txomin-guardia/ROUSGARDEN/image/ROUSGarden 2.jpg

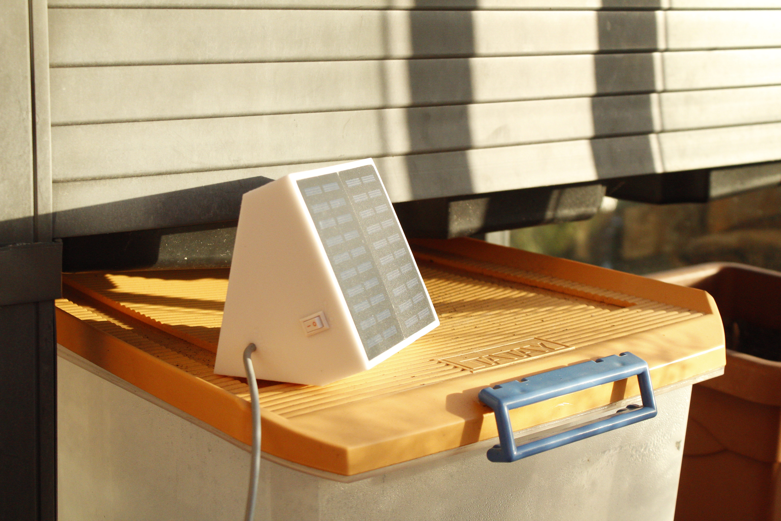
image/ROUSGarden 2.jpg
