txomin-guardia/ROUSGARDEN/image/ROUSGarden 4.jpg

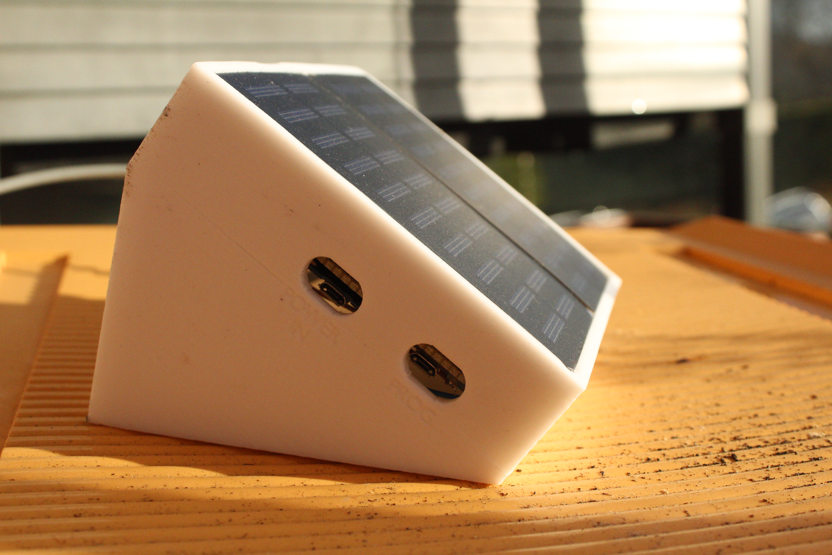
image/ROUSGarden 4.jpg
