txomin-guardia/ROUSGARDEN/image/ROUSGarden 5.jpg

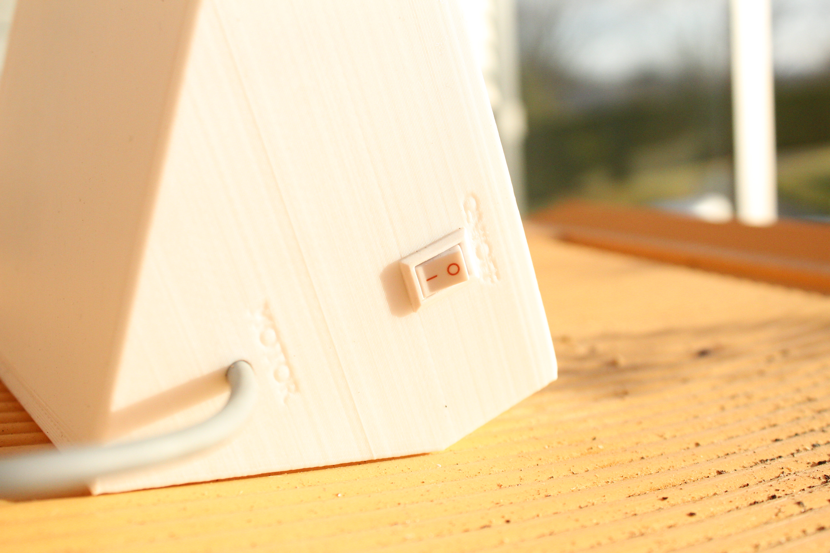
image/ROUSGarden 5.jpg
