txomin-guardia/ROUSGARDEN/image/ROUSGarden 6.jpg

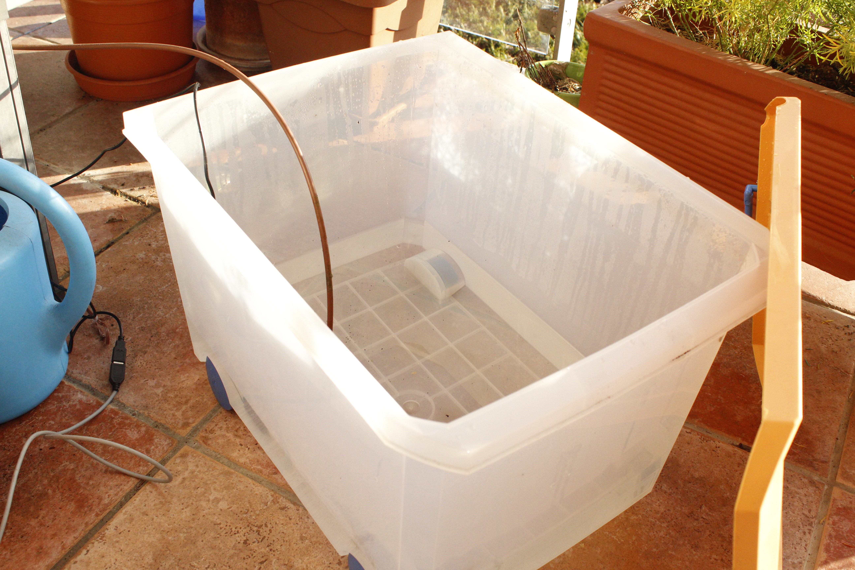
image/ROUSGarden 6.jpg
