txomin-guardia/ROUSGARDEN/image/ROUSGarden 7.jpg

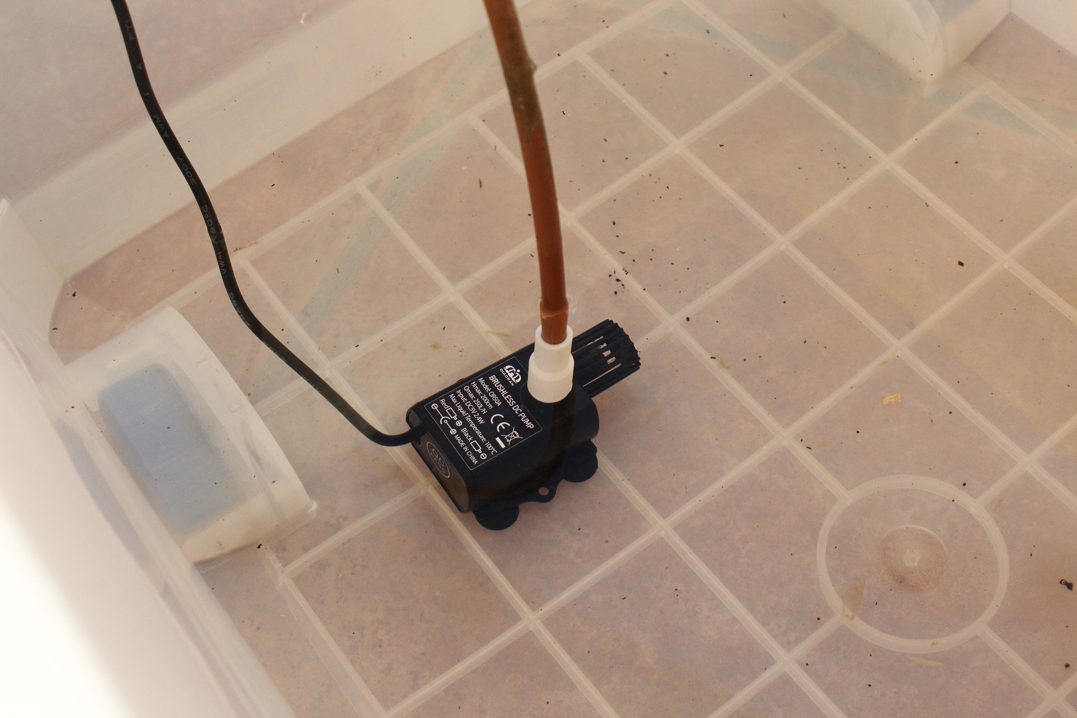
image/ROUSGarden 7.jpg
