txomin-guardia/ROUSGARDEN/image/ROUSGardeN - Case 1.png

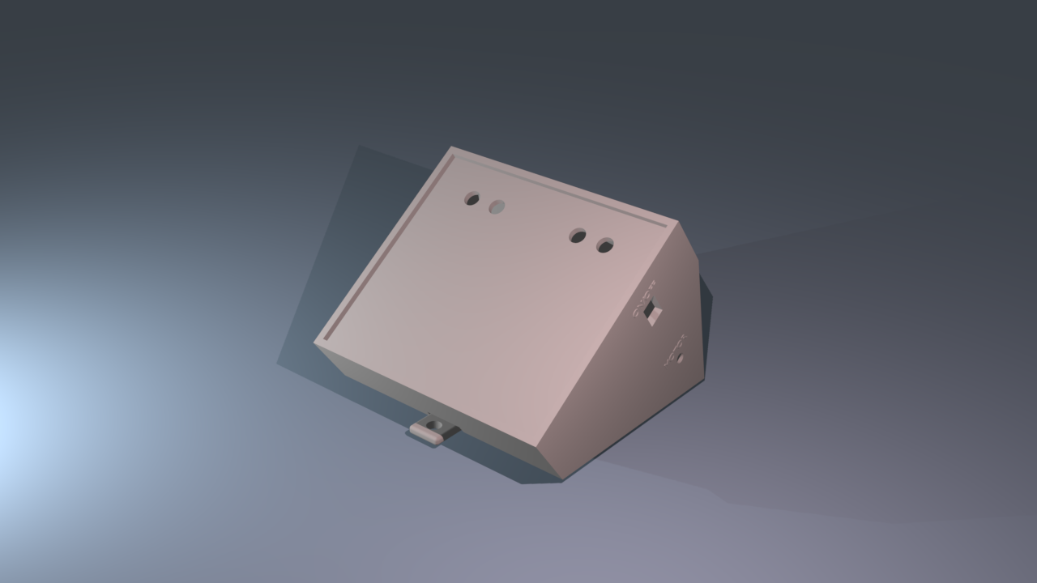
image/ROUSGardeN - Case 1.png
