txomin-guardia/ROUSGARDEN/doc/ROUSGardeN 1.0 - BOM.md

ROUSGardeN 1.0
==============

BILL OF MATERIALS

* 1 x Mini wifi board WEMOS D1 Mini V3.0.0 WIFI ESP8266 4MB (https://www.banggood.com/Geekcreit-D1-Mini-V3_0_0-WIFI-Internet-Of-Things-Development-Board-Based-ESP8266-4MB-p-1264245.html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)
* 1 x DC 5V 1CH Relay Shield V2 Version 2 For D1 Mini ESP8266 WiFi Module (https://www.banggood.com/DC-5V-1CH-Relay-Shield-V2-Version-2-For-D1-Mini-ESP8266-WiFi-Module-p-1102379.html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)
* 1 x 3.7V 9V 5V 2A Adjustable Step Up 3,7V Lithium Battery Charging Discharge Integrated Module (https://www.banggood.com/3_7V-9V-5V-2A-Adjustable-Step-Up-18650-Lithium-Battery-Charging-Discharge-Integrated-Module-p-1264852.html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)
* 1 x Rechargeable Batery 3.7V 4000mAh Li-polymer Battery 5050100 Li-Po (https://es.aliexpress.com/item/32810827153.html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)
* 2 x 107mm x 61mm 1 Watt 5 Volts Monocrystalline Solar Cell Panel Module (https://es.aliexpress.com/item/33043118065.html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,scm-url:1007.40050.281175.0,pvid:6043324d-6fd0-4a92-81bd-c17b8e9e5d3b,tpp_buckets:668%232846%238110%231995&pdp_ext_f=%7B%22sku_id%22%3A%2267356190824%22%2C%22sceneId%22%3A%2230050%22%7D&pdp_npi=2%40dis%21EUR%211.81%211.67%21%21%21%21%21%400b0a23ae16677584363356863e7c06%2167356190824%21rec)
* 1 x Brushless mini waterpump USB DC 5V 2.4W 250L / 2m (https://www.amazon.es/dp/B07KQ1W4NP/ref=cm_sw_r_em_apap_VDhx8IsJr9Qqy)
* 1 x KCD11 Rocker Switch 10*15mm Mini Push Button Switch ON-OFF 3 Pins 3A 250VAC(https://www.aliexpress.com/item/4000973563250.html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)
