txomin-guardia/ROUSGARDEN/doc/ROUSGardeN 1.0 - Circuit Diagram.pdf

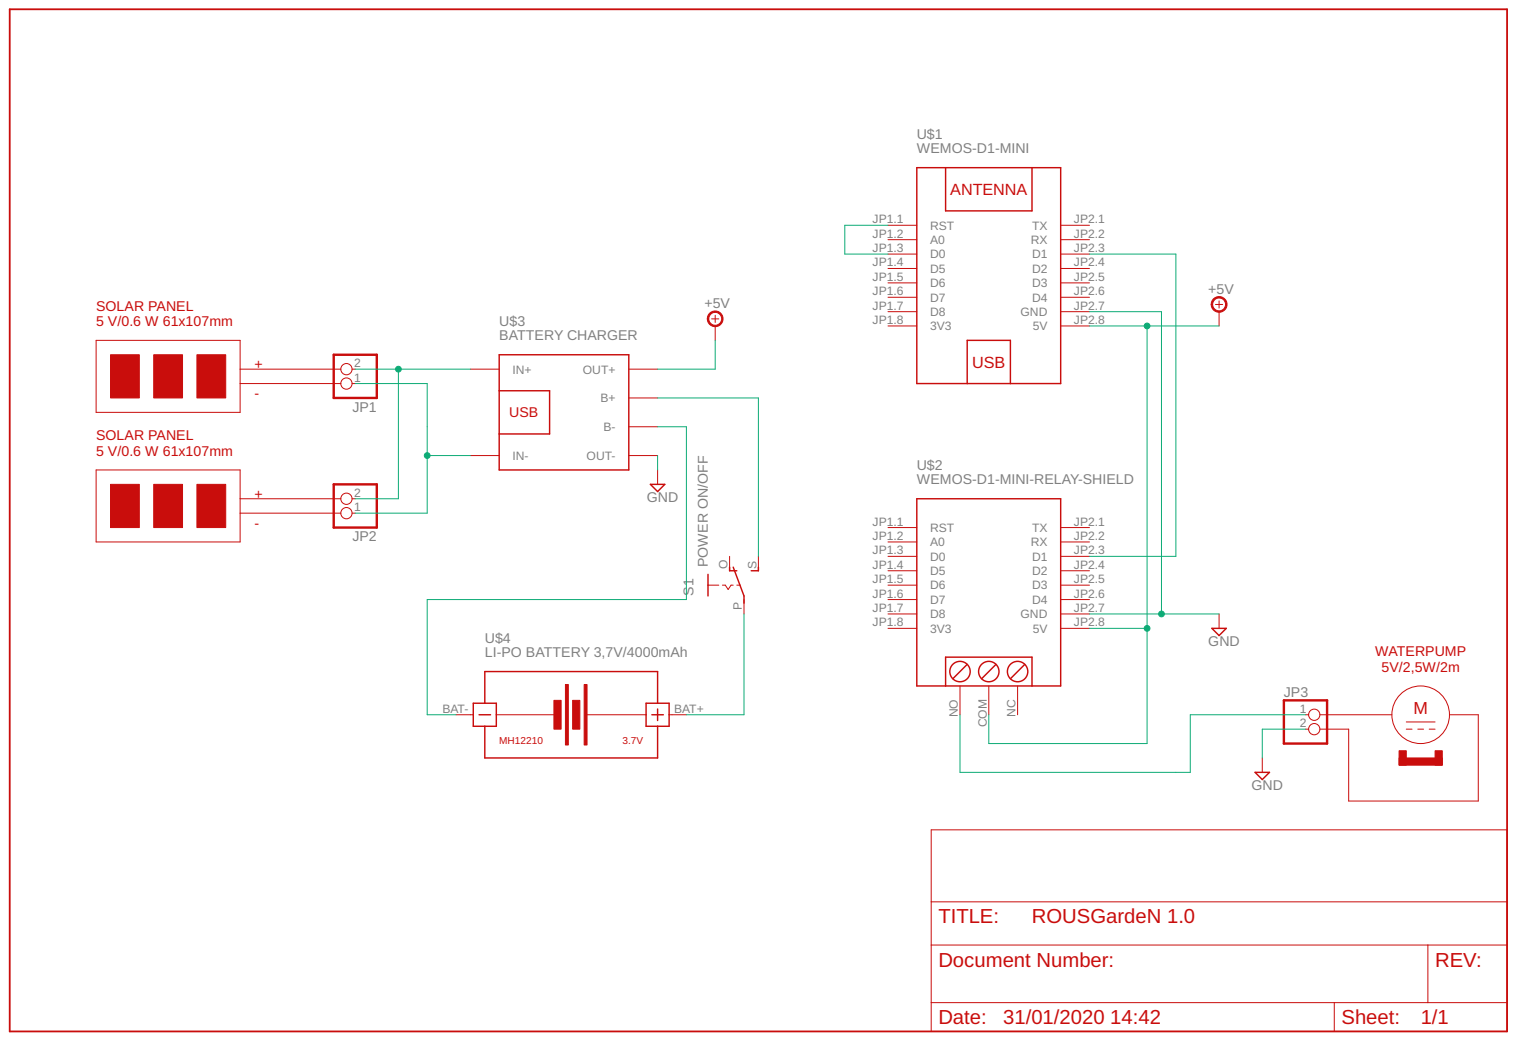
[picture p12: page 1]

WER ON/OFF GND

WEMOS-D1-MINI-RELAY-SHIELD

JP2.3 D2 JP2.4 D3 JP2.5 D4 JP2.6 GND JP2.7

Document Number: | REV:

Date: 31/01/2020 14:42 | Sheet: 1/1
