txomin-guardia/ROUSGARDEN/ROUSGardeN/RousGarden.ino

/* ROUSGardeN
    
    Autonomous and Unattended Watering System, ESP8266 controlled with two daily tasks
    
    Copyright (c) 2019 Txomin Guardia
    
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
    V1.0 2019-10-6
        
    (^\s*if \(WithSerialDebug\) \{)(.*?)(\})
    
    \n#if WITH_SERIAL_DEBUG\2\#endif
*/

#include <ESP8266WiFi.h>
#include <CayenneMQTTESP8266.h>
#include "credentials.h"
#include "ESPRelayTaskNTP.h"

extern "C" {
    #include "user_interface.h" // this is for the RTC memory read/write functions
}

// WEMOS_D1_MINI used pins to control relay
#define RESET_PIN 12  //It corresponds to WEMOS D1 MINI - pin D6
#define RELAY_ON_PIN 5  //It corresponds to WEMOS D1 MINI - pin D1

#define WITH_SERIAL_DEBUG 1
//#define WITH_CAYENNE_DEBUG 1

//Working with Cayenne
#if WITH_CAYENNE_DEBUG
    #define CAYENNE_PRINT Serial
#endif

//On & Off enumeration
enum OnOffOption {
    Off,
    On
};

// Debugging through Cayenne IoT Project Builder
const OnOffOption WithCayenneDebug = Off;

// This is the instatiation of the main class that controls the relay
// Usage:   relayTask(Task #1 Hour, Task #1 Minute, Task #1 Time On (seg), Task #2 Hour, Task #2 Minute, Task #2 Time On (seg), Timezone, WiFi SSID, WiFi PASSWORD, Reset Pin);
// Only Task 1 will be executed if the hour and minute of Task 2 is less than that of Task 1.
ESPRelayTaskNTP relayTask(0, 0, 0, 0, 0, 0, 1.0, my_SSID, my_PASSWORD, RESET_PIN);

void setup() {
    unsigned int timeTaskOn;
    
    #if WITH_SERIAL_DEBUG
        Serial.begin(115200);
        while (!Serial) {
            ; // wait for serial port to connect. Needed for native USB
        }
        Serial.println();   Serial.println("Start");   Serial.println();
    #endif
    
    //Relay task schedule configuration
    relayTask._wakeupTask1.hour = 8; //Hour of the day
    relayTask._wakeupTask1.minute = 0; //Minute of the day
    relayTask._wakeupTask1.second = 60; //Duration in sec
    relayTask._wakeupTask2.hour = 20; //Hour of the day
    relayTask._wakeupTask2.minute = 5; //Minute of the day
    relayTask._wakeupTask2.second = 60; //Duration in sec
    
    relayTask.sleepOneDay();
    
    // ------------------ put the code for the tasks here -------------------------------
    
    if (WithCayenneDebug) {
        // Initialize Cayenne connection also activating the wifi because Wi-Fi is not
        // started by default when the job is activated.
        Cayenne.begin(username, password, clientID, my_SSID, my_PASSWORD);
        // Inform Cayenne the ON state
        Cayenne.digitalSensorWrite(0, true);
    }
    
    timeTaskOn = relayTask.readTimeTaskOn();
    
    #if WITH_SERIAL_DEBUG
        Serial.println("............ W O R K I N G ............");
        Serial.print("Task in progress for ");
        Serial.print(timeTaskOn);
        Serial.println("s");
    #endif
    
    //Relay switch ON
    pinMode(RELAY_ON_PIN, OUTPUT);
    digitalWrite(RELAY_ON_PIN, true);
    
    delay(timeTaskOn * 1e3);
    
    digitalWrite(RELAY_ON_PIN, false);
    
    if (WithCayenneDebug) {
        // Inform Cayenne the OFF state
        Cayenne.digitalSensorWrite(0, false);
        delay(1000);
    }
    
    relayTask.backToSleep();
}

void loop() {
    // loop never reached
}
