txomin-guardia/ROUSGARDEN/(commit log)

2020-01-31 BOM added
2020-01-31 Update ROUSGardeN 1.0 - BOM.md
2022-11-06 Cambiada tienda de paneles solares
2024-12-04 Update ROUSGardeN 1.0 - BOM.md
    Añadida nueva referencia de batería
2024-12-04 Update ROUSGardeN 1.0 - BOM.md
    Añadido interruptor
