txomin-guardia/ROUSGARDEN/image/ROUSGarden 3.jpg

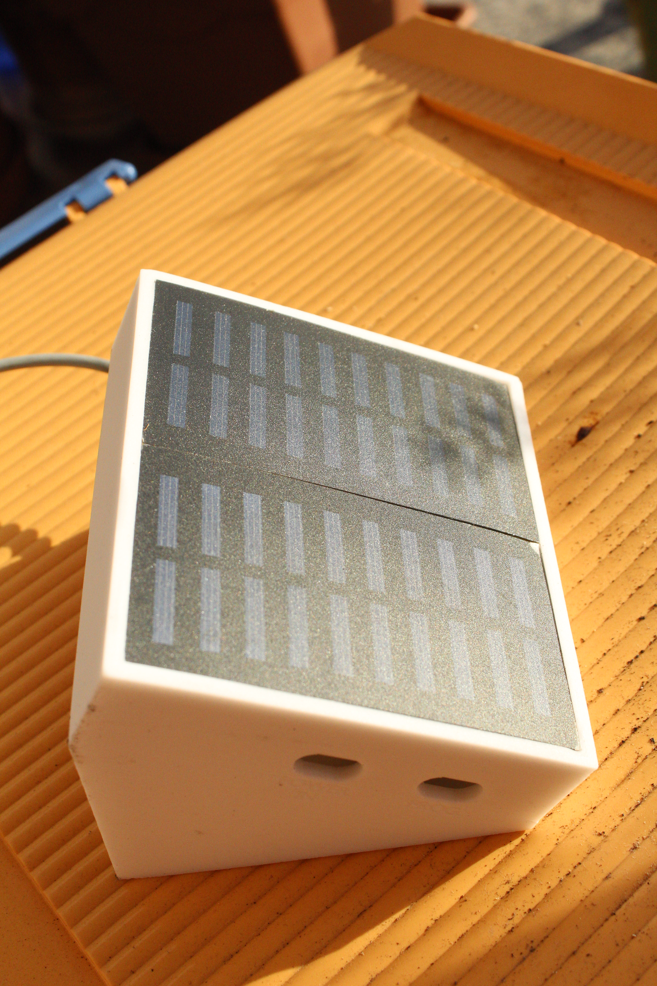
image/ROUSGarden 3.jpg
