txomin-guardia/ROUSGARDEN/image/ROUSGarden 9.jpg

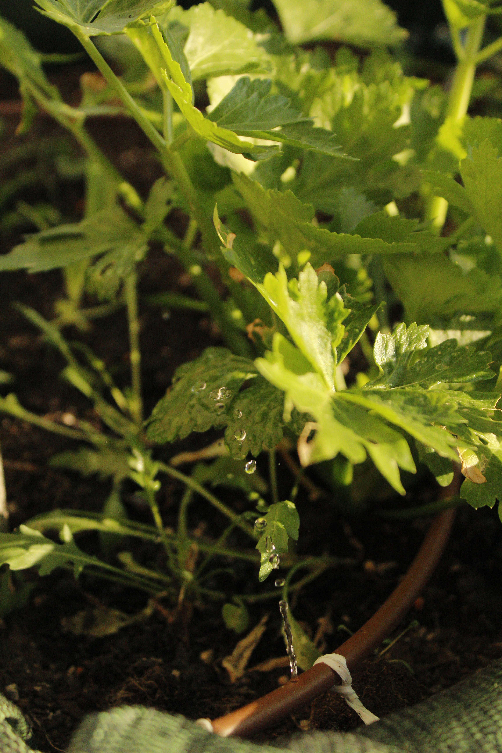
image/ROUSGarden 9.jpg
