txomin-guardia/ROUSGARDEN/image/ROUSGarden 10.jpg

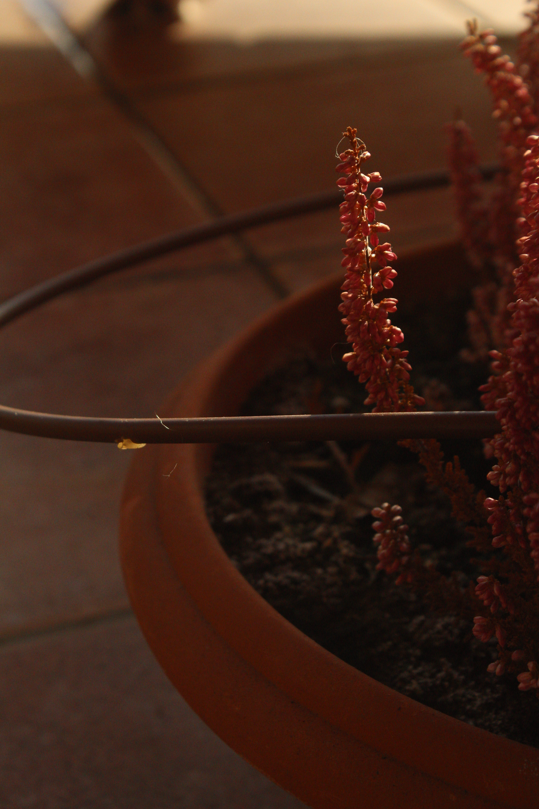
image/ROUSGarden 10.jpg
