txomin-guardia/ROUSGARDEN/image/ROUSGarden 1.jpg

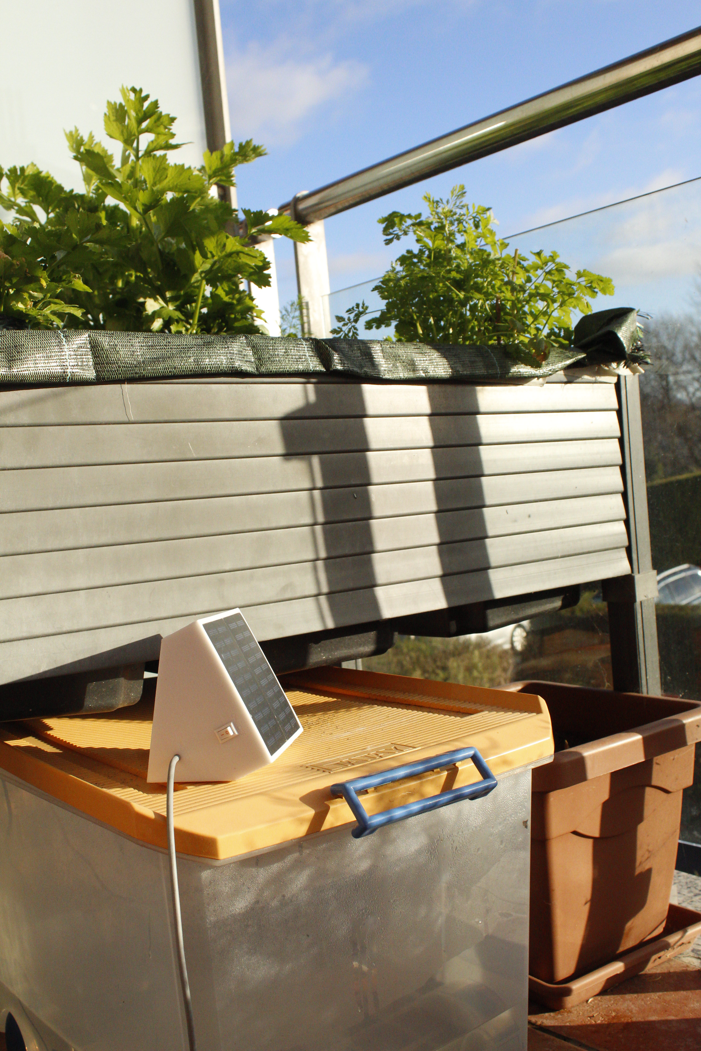
image/ROUSGarden 1.jpg
