txomin-guardia/ROUSGARDEN/image/ROUSGarden 8.jpg

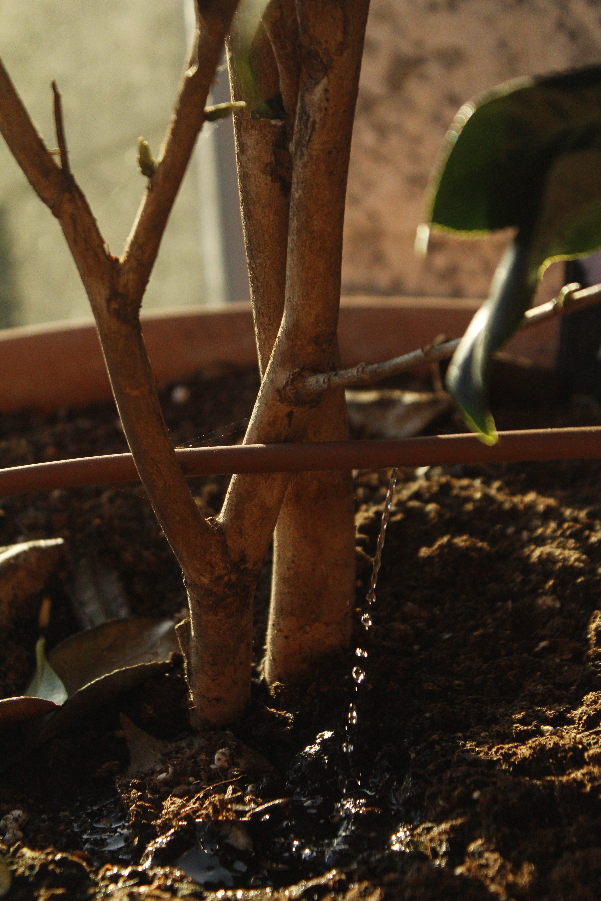
image/ROUSGarden 8.jpg
